hatatthang/quadruped-trajectory-tracking/media/floor_plane.png

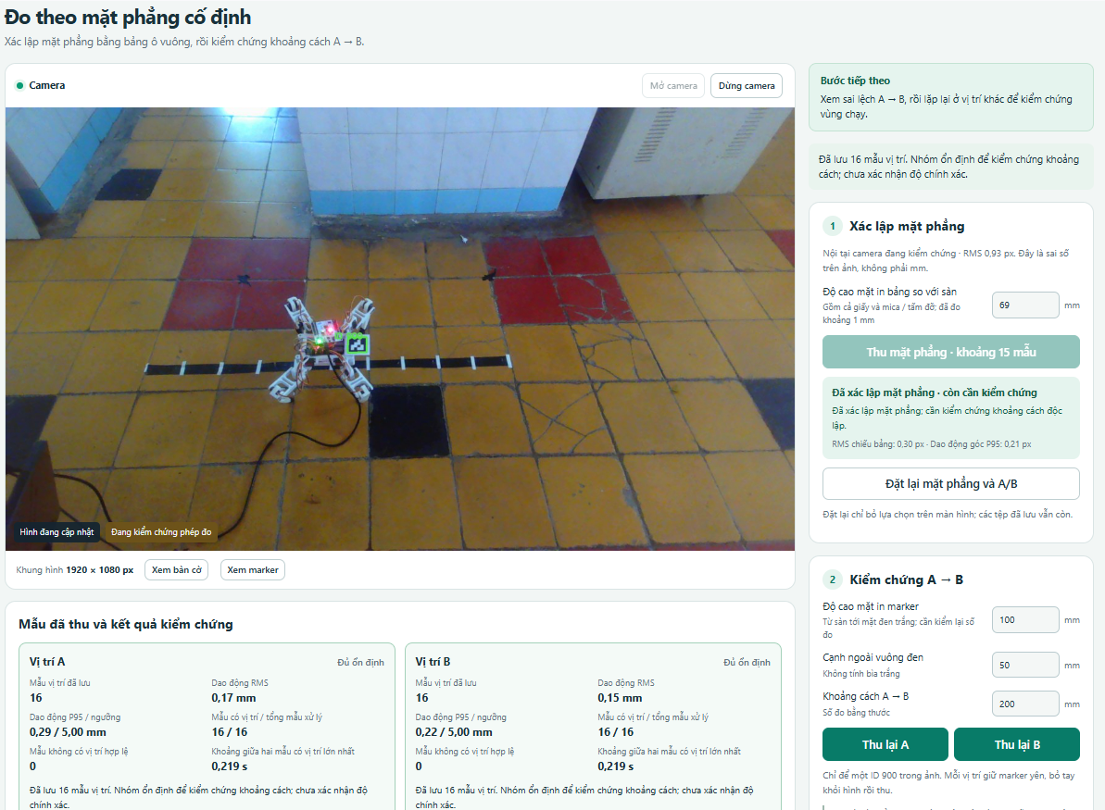
media/floor_plane.png
