hatatthang/quadruped-trajectory-tracking/media/ui.png

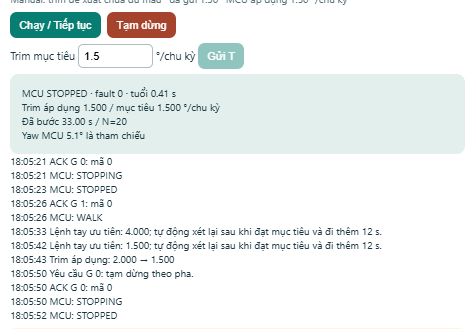
media/ui.png
