hatatthang/quadruped-trajectory-tracking/cad/topcover.STEP

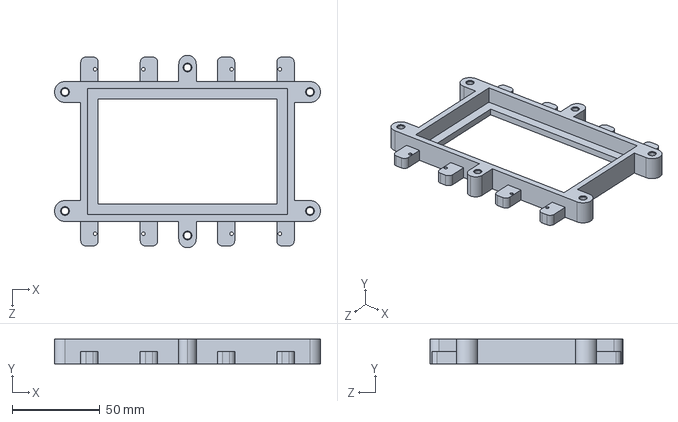
[picture p59: CAD file, 2026-10-27]
cad/topcover.STEP
152.0 x 14.0 x 110.0 mm
