hatatthang/quadruped-trajectory-tracking/cad/botcover_fix_2..STEP

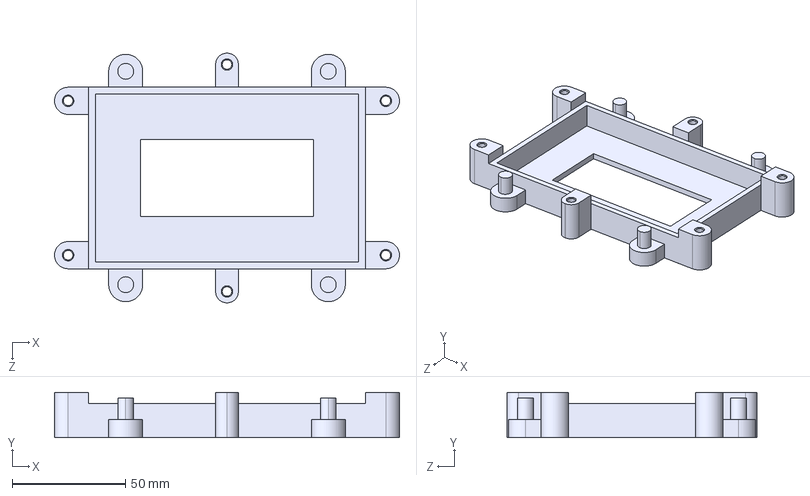
[picture p60: CAD file, 2026-10-27]
cad/botcover_fix_2..STEP
152.0 x 20.0 x 110.0 mm
