hatatthang/quadruped-trajectory-tracking/cad/quadruped pider robot.STEP

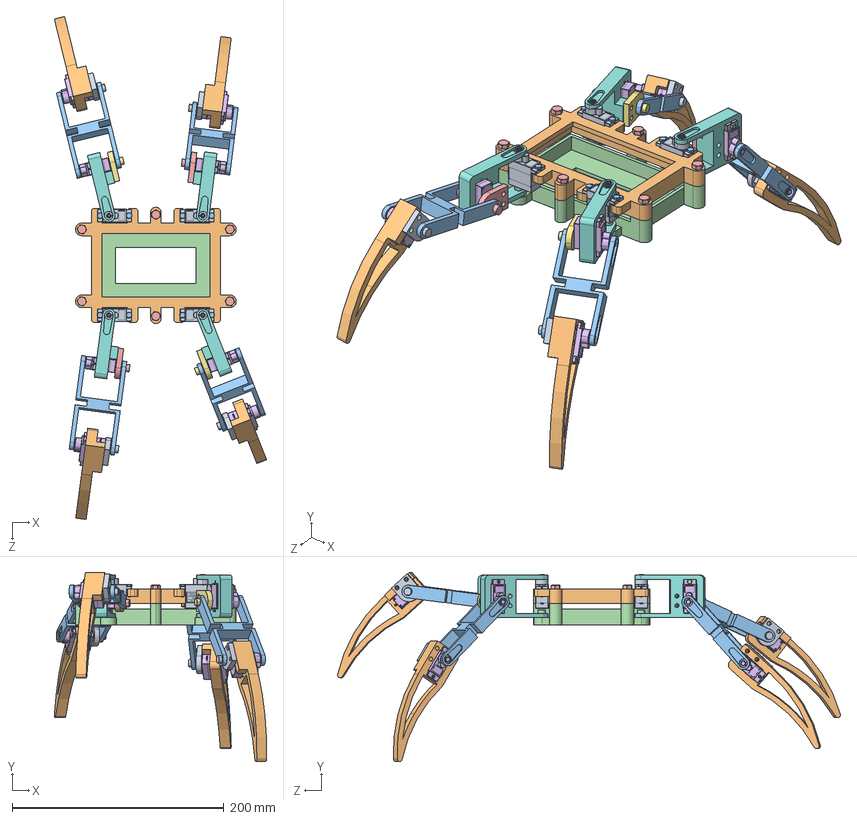
[picture p61: CAD file, 2026-10-27]
cad/quadruped pider robot.STEP
200.7 x 179.0 x 475.4 mm
Tower Pro MG90S Micro servo.step x 4
topcover
hex screw gradeab_iso_ISO 4017 - M2.5 x 10-N x 8
botcover
m5x20.step x 6
Tower Pro MG90S Micro servo x 8
small_connection x 2
body_connection_1 x 2
small_connection_2 x 4
leg_final_1 x 2
leg_connection x 4
hex screw_am_B18.6.7M - M2.5 x 0.45 x 8 Indented HHMS --8N x 4
body_connection x 2
small_connection_1 x 2
leg_final x 2
