hatatthang/quadruped-trajectory-tracking/cad/leg_connection.STEP

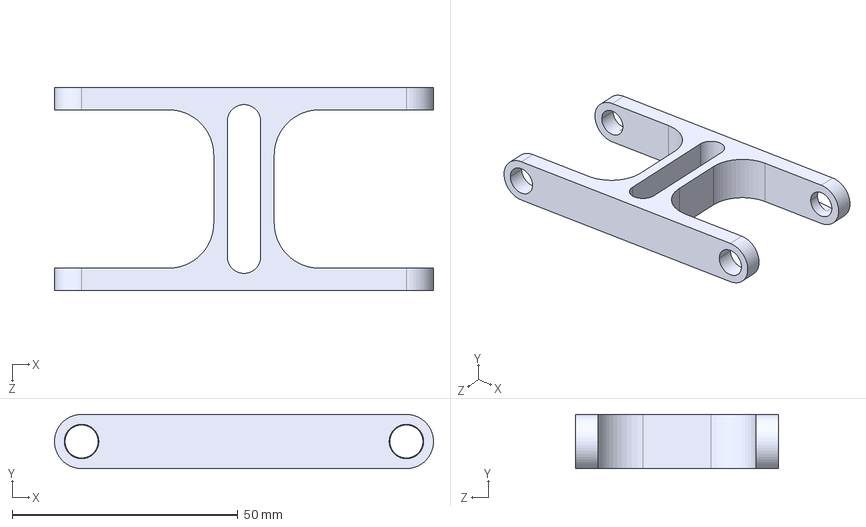
[picture p62: CAD file, 2026-10-27]
cad/leg_connection.STEP
84.0 x 12.0 x 45.1 mm
