hatatthang/quadruped-trajectory-tracking/cad/botcover.STEP

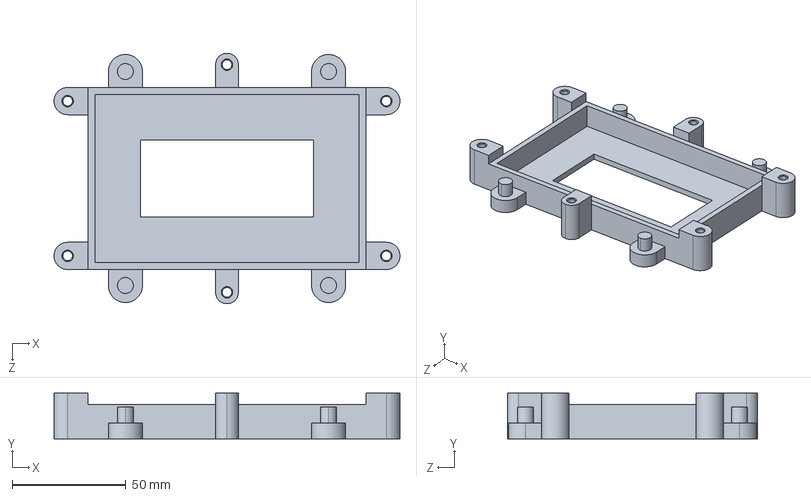
[picture p63: CAD file, 2026-10-27]
cad/botcover.STEP
152.0 x 20.0 x 110.0 mm
