hatatthang/quadruped-trajectory-tracking/cad/small_connection_0.STEP

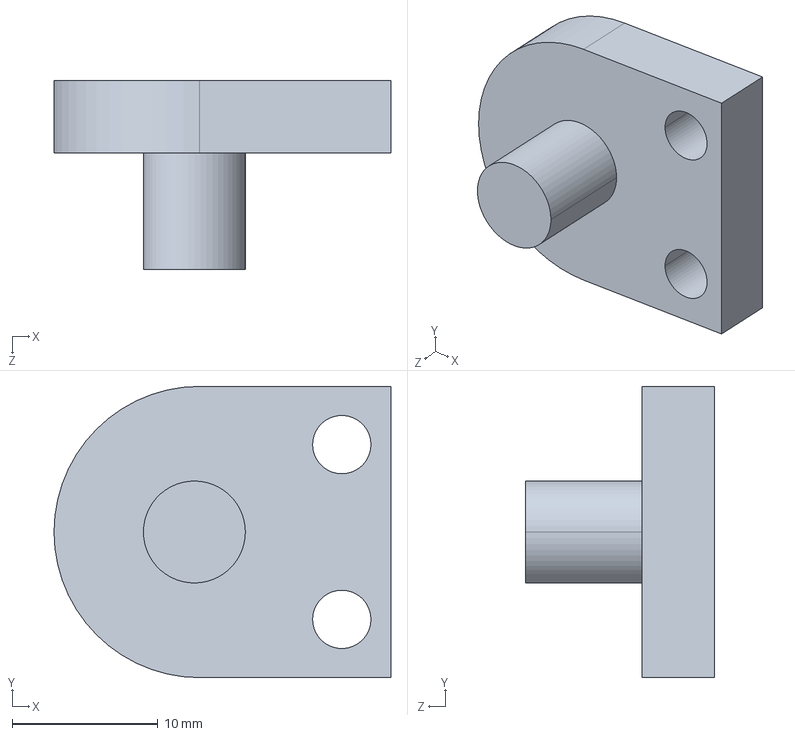
[picture p64: CAD file, 2026-10-27]
cad/small_connection_0.STEP
23.1 x 20.0 x 13.0 mm
