hatatthang/quadruped-trajectory-tracking/(list of files, cad)

Other CAD files:
cad/botcover_fix.STEP
cad/botcover_fix_2.STEP
