hatatthang/quadruped-trajectory-tracking/media/circle_result.png

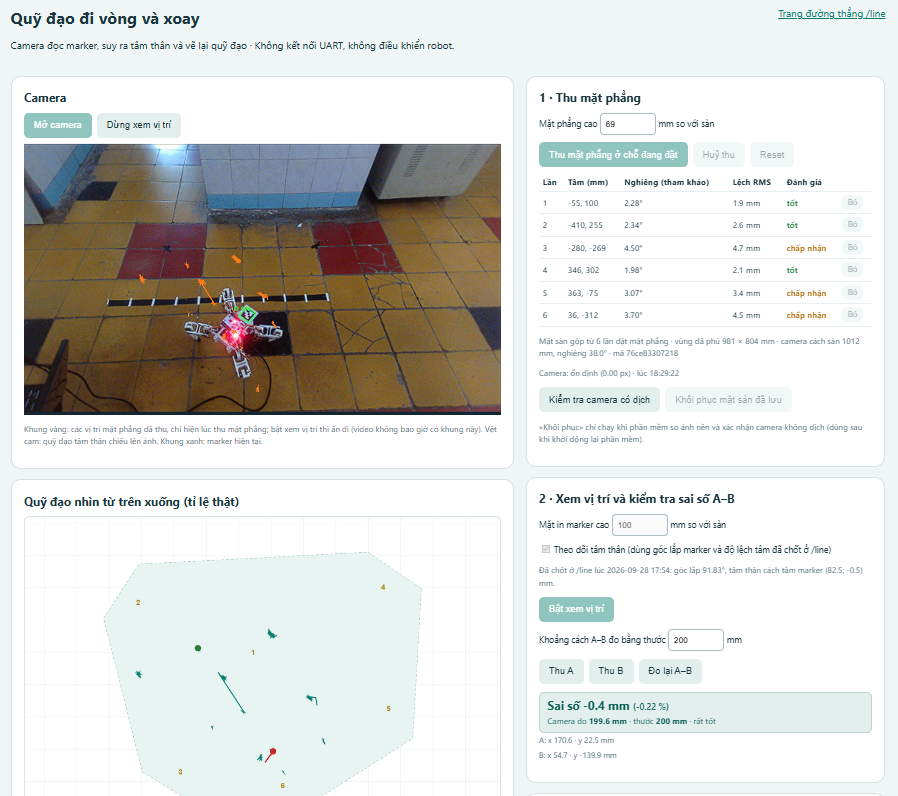
media/circle_result.png
